raninduwathsal/Ratatouille/PCBS/Etching-Ready/Mainboaard/mainboard-Etching-ready-B_Cu.pdf

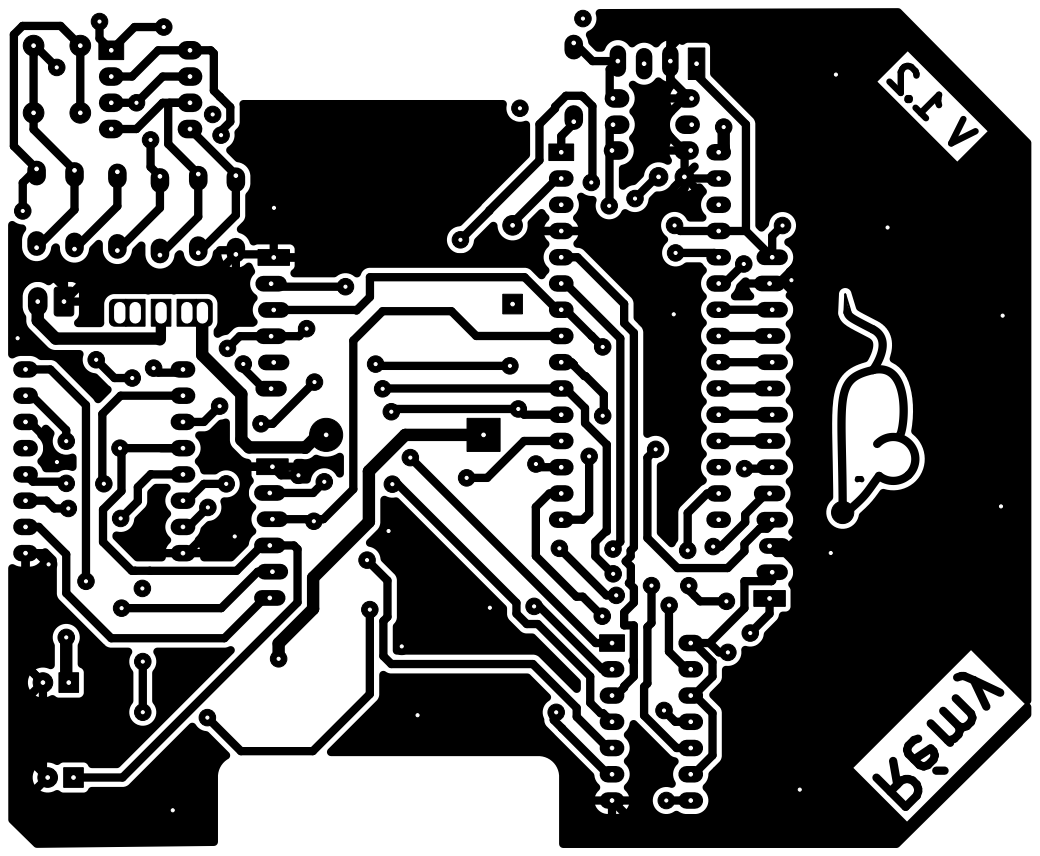
[picture p1: page 1]
