raninduwathsal/Ratatouille/PCBS/Etching-Ready/Mainboaard/mainboard-Etching-ready-F_Cu.pdf

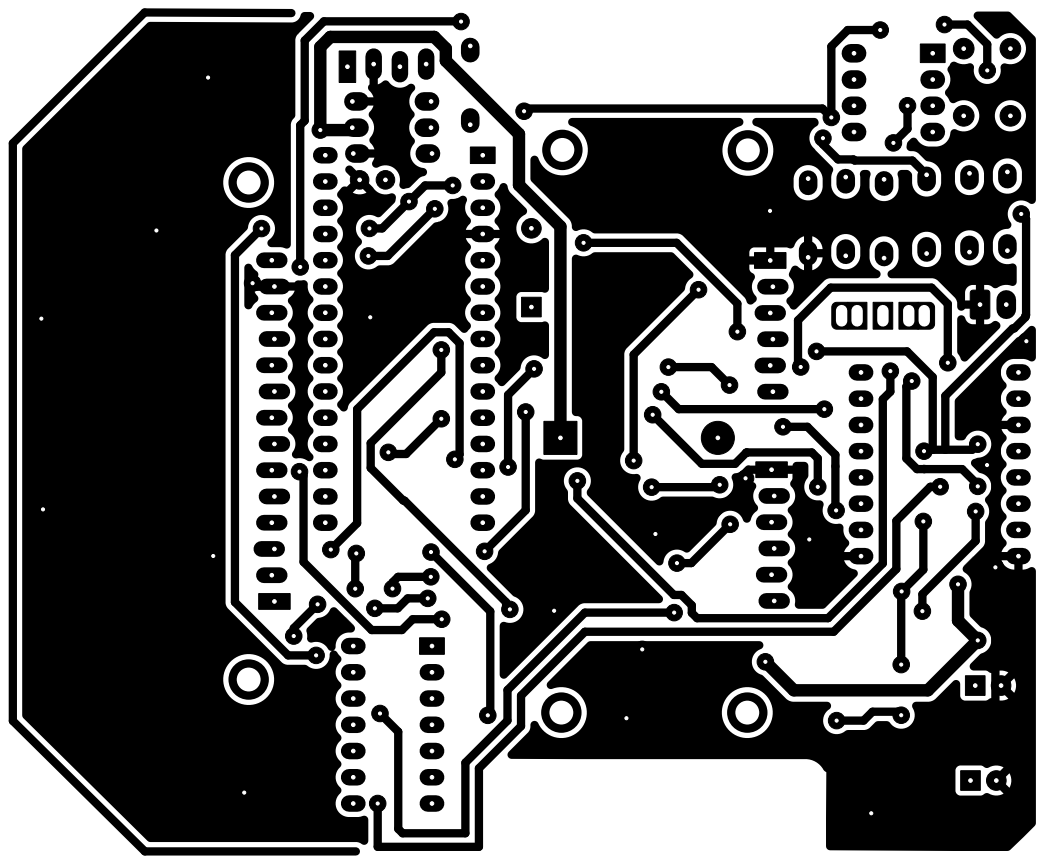
[picture p2: page 1]
