raninduwathsal/Ratatouille/PCBS/Etching-Ready/Wall-Sensor-Adavnced/wall-sensor-advanced-bottom_layer.pdf

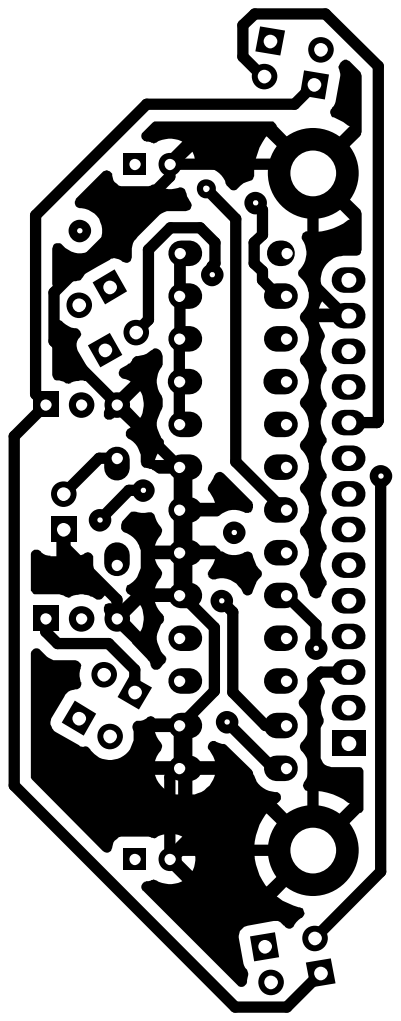
[picture p3: page 1]
