raninduwathsal/Ratatouille/PCBS/Etching-Ready/Wall-Sensor-Adavnced/wall-sensor-advanced-top_layer.pdf

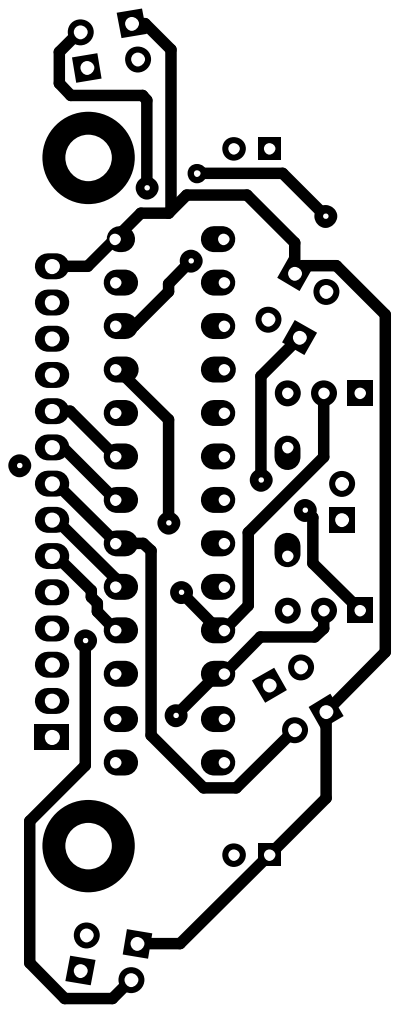
[picture p4: page 1]
