raninduwathsal/Ratatouille/PCBS/Ki-cad/mainboard-Etching-ready.kicad_pcb

## KiCad design PCBS/Ki-cad/mainboard-Etching-ready.kicad_pcb (2025-08-02)

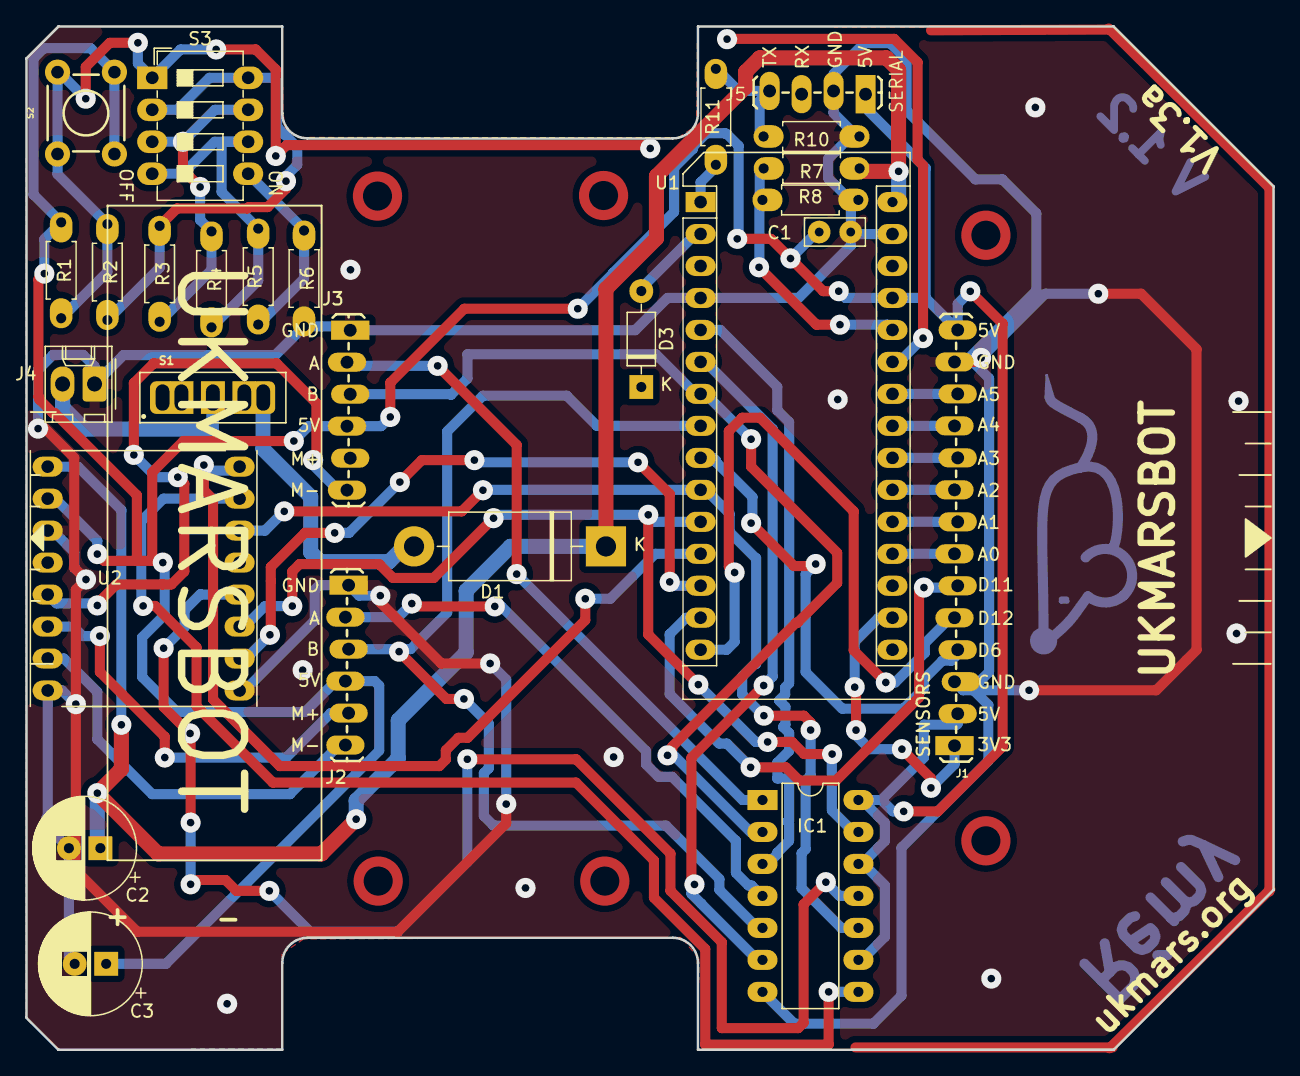
[picture p5: board mainboard-Etching-ready.kicad_pcb from above]

Board: 2 copper layers, 99.1 x 81.3 mm, 26 parts (0 on the bottom side), 41 nets.

Parts:
C1: 100n; C_Rect_L4.6mm_W2.0mm_P2.50mm_MKS02_FKP02
C2, C3: 330uF, 16V; CP_Radial_D8.0mm_P2.50mm
D1: 1N5401; D_DO-201AD_P15.24mm_Horizontal
D3: 1N4148; D_DO-35_SOD27_P7.62mm_Horizontal
IC1: 74HC86; DIP-14_W7.62mm_LongPads
J1: SENSORS; 1X14_LOCK_LONGPADS
J2, J3: CONN_06SILK_FEMALE_PTH; 1X06_LOCK_LONGPADS
J4: POWER; Molex_KK-254_AE-6410-02A_1x02_P2.54mm_Vertical
J5: SERIAL; 1X04_LOCK_LONGPADS
R1, R2, R10: 10k; R_Axial_DIN0207_L6.3mm_D2.5mm_P7.62mm_BIGPAD
R3, R11: 4k7; R_Axial_DIN0207_L6.3mm_D2.5mm_P7.62mm_BIGPAD
R4: 2k2; R_Axial_DIN0207_L6.3mm_D2.5mm_P7.62mm_BIGPAD
R5: 1k0; R_Axial_DIN0207_L6.3mm_D2.5mm_P7.62mm_BIGPAD
R6: 470; R_Axial_DIN0207_L6.3mm_D2.5mm_P7.62mm_BIGPAD
R7, R8: 15k; R_Axial_DIN0207_L6.3mm_D2.5mm_P7.62mm_BIGPAD
S1: sub-miniature, SPDT; SW_MINI-SPDT-RTECH-78-0564
S2: BUTTON; TACTILE_SWITCH_PTH_6.0MM
S3: DIP-SW; SW_DIP_SPSTx04_Slide_6.7x11.72mm_W7.62mm_P2.54mm_LowProfile
U1: Arduino_Nano
U2: TB6612FNG-Module; TB6612FNG-module

Connections:
5V: C1.1, C3.1, IC1.9, IC1.12, IC1.14 (VCC), J1.2, J1.14, J2.4, J3.4, J5.1, R1.2, S2.3, S2.4, U1.27 (+5V), U2.2 (VCC), U2.13 (STBY)
/3V3: J1.1, U1.17 (3V3)
/BATTERY_VOLTS: R7.1, R8.2, U1.26 (A7/D21)
/EMITTER_A: J1.6, U1.14 (~D11)
/EMITTER_B: J1.5, U1.15 (D12)
/FUNCTION_SELECT: R1.1, R2.2, S2.1, S2.2, S3.1, U1.25 (A6/D20)
/LEFT_A: IC1.1, J3.2
/LEFT_B: IC1.2, J3.3, U1.7 (D4)
/LEFT_CLK_A: IC1.3, U1.5 (D2)
/LEFT_DIR: IC1.10, U1.10 (D7), U2.14 (AI1)
/LEFT_MOTOR_1: J3.5, U2.4 (A01)
/LEFT_MOTOR_2: J3.6, U2.5 (A02)
/LEFT_PWM: U1.12 (~D9), U2.16 (PWMA)
/PWR_IN: J4.2, S1.2
/RIGHT_A: IC1.4, J2.2
/RIGHT_B: IC1.5, J2.3, U1.8 (~D5)
/RIGHT_CLK_A: IC1.6, U1.6 (~D3)
/RIGHT_DIR: IC1.13, U1.11 (D8), U2.11 (BI2)
/RIGHT_MOTOR_1: J2.6, U2.7 (B01)
/RIGHT_MOTOR_2: J2.5, U2.6 (B02)
/RIGHT_PWM: U1.13 (~D10), U2.10 (PWMB)
/RXD: D3.2 (A), U1.2 (D0/RX)
/RXD_BT: D3.1 (K), J5.3
/SENSOR_0: J1.7, U1.19 (A0/D14)
/SENSOR_1: J1.8, U1.20 (A1/D15)
/SENSOR_2: J1.9, U1.21 (A2/D16)
/SENSOR_3: J1.10, U1.22 (A3/D17)
/SENSOR_4: J1.11, U1.23 (A4/D18)
/SENSOR_5: J1.12, U1.24 (A5/D19)
/SW_PWR: D1.2 (A), S1.3 (S)
/TXD: R11.2, U1.1 (D1/TX)
/TXD_BT: J5.4, R10.1, R11.1
/USER_IO: J1.4, U1.9 (~D6)
/V_BATT: C2.1, D1.1 (K), R7.2, U1.30 (VIN), U2.1 (VM)
//LEFT_DIR: IC1.8, U2.15 (AI2)
//RIGHT_DIR: IC1.11, U2.12 (BI1)
GND: C1.2, C2.2, C3.2, IC1.7 (GND), J1.3, J1.13, J2.1, J3.1, J4.1, J5.2, R6.1, R8.1, R10.2, U1.4 (GND), U1.29 (GND), U2.3 (GND), U2.8 (GND), U2.9 (GND)
unnamed: R2.1, R3.2, S3.2 (1), S3.8 (2)
unnamed: R3.1, R4.2, S3.3 (1), S3.7 (2)
unnamed: R4.1, R5.1, S3.4 (1), S3.6 (2)
unnamed: R5.2, R6.2, S3.5 (2)
