raninduwathsal/Ratatouille/PCBS/Ki-cad/ukmarsbot-wall-sensor-advanced-etch diy.kicad_pcb

## KiCad design PCBS/Ki-cad/ukmarsbot-wall-sensor-advanced-etch diy.kicad_pcb (2025-07-12)

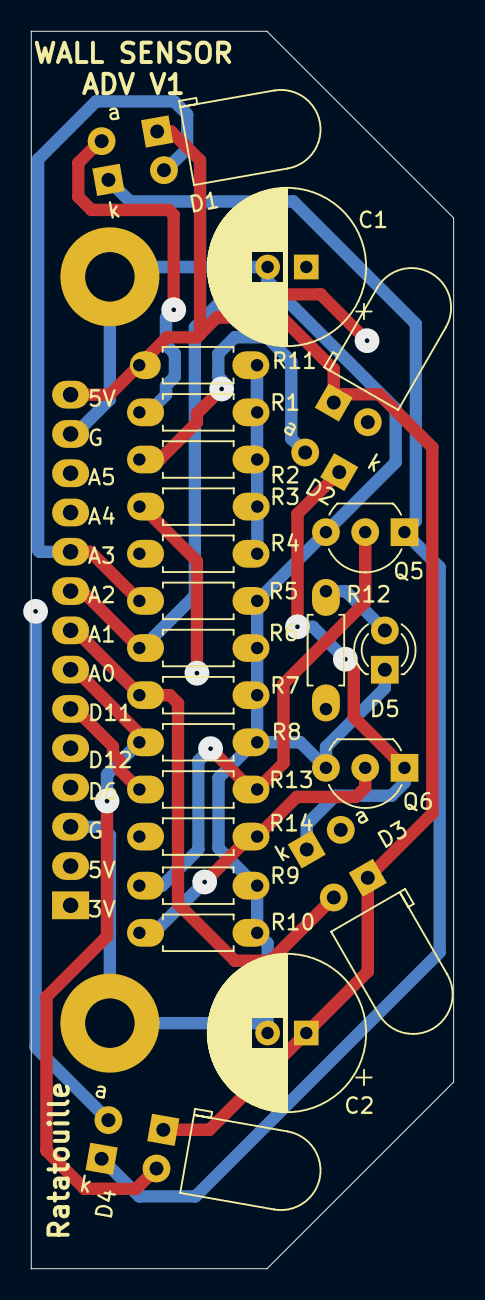
[picture p6: board ukmarsbot-wall-sensor-advanced-etch diy.kicad_pcb from above]

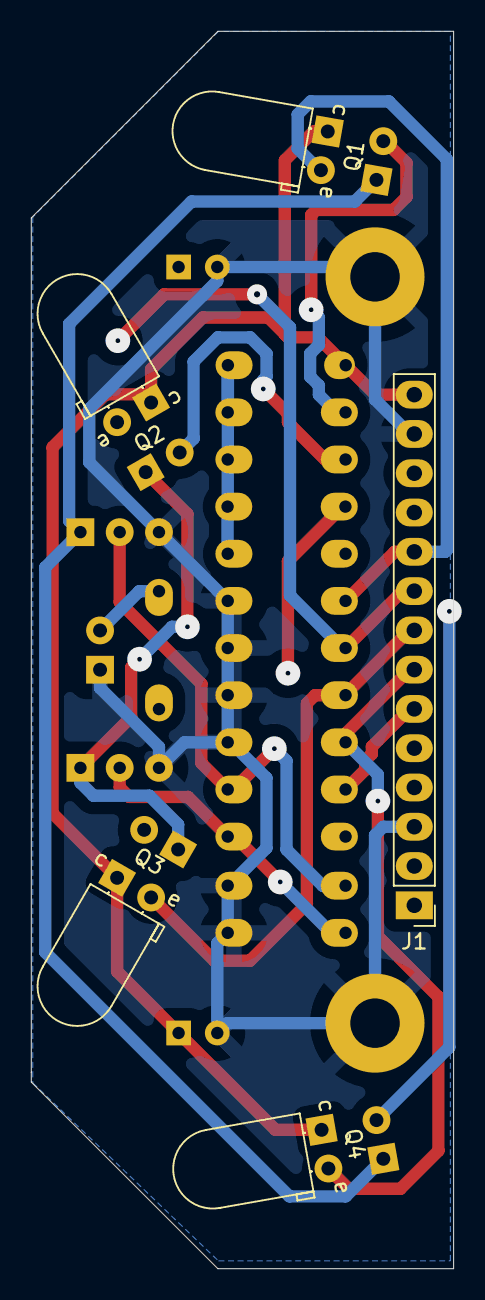
[picture p7: board ukmarsbot-wall-sensor-advanced-etch diy.kicad_pcb from below]

Board: 2 copper layers, 27.3 x 80.0 mm, 30 parts (5 on the bottom side), 19 nets.

Parts:
C1, C2: 330uF, 16V; CP_Radial_D10.0mm_P2.50mm
D1, D2, D3, D4: SFH4545; LED_D5.0mm_Horizontal_O6.35mm_Z3.0mm
D5: LED; LED_D3.0mm
H1, H2: 3.2mm; MountingHole_3.2mm_M3_Pad
J1: Conn_01x14; PinHeader_1x14_P2.54mm_Vertical_Longpads
Q1, Q2, Q3, Q4: TEFT4300; LED_D5.0mm_Horizontal_O1.27mm_Z3.0mm_IRGrey
Q5, Q6: BC337; TO-92_Inline_Wide_HandSolder
R1, R2, R3, R4: 10R; R_Axial_DIN0207_L6.3mm_D2.5mm_P7.62mm_BIGPAD
R5, R6, R7, R8: 1k8; R_Axial_DIN0207_L6.3mm_D2.5mm_P7.62mm_BIGPAD
R9, R10: 100k; R_Axial_DIN0207_L6.3mm_D2.5mm_P7.62mm_BIGPAD
R11: 33; R_Axial_DIN0207_L6.3mm_D2.5mm_P7.62mm_BIGPAD
R12: 1k0; R_Axial_DIN0207_L6.3mm_D2.5mm_P7.62mm_BIGPAD
R13, R14: 390R; R_Axial_DIN0207_L6.3mm_D2.5mm_P7.62mm_BIGPAD

Connections:
5V: C2.1, J1.14, Q1.1 (C), Q2.1 (C), Q3.1 (C), Q4.1 (C), R11.2
/DIA_COMMON: D2.1 (K), D3.1 (K), Q6.1 (C)
/FWD_COMMON: D1.1 (K), D4.1 (K), Q5.1 (C)
A0_RF: J1.7, Q4.2 (E), R8.1
A1_RD: J1.8, Q3.2 (E), R7.1
A2_LD: J1.9, Q2.2 (E), R6.1
A3_LF: J1.10, Q1.2 (E), R5.1
D6_LED: J1.4, R12.2
D11_FRONT: J1.6, R13.1
D12_DIAGONAL: J1.5, R14.1
GND: C1.2, C2.2, D5.1 (K), H1.1, H2.1, J1.3, J1.13, Q5.3 (E), Q6.3 (E), R5.2, R6.2, R7.2, R8.2, R9.2, R10.2
unnamed: D1.2 (A), R1.1
unnamed: D2.2 (A), R2.1
unnamed: D3.2 (A), R3.1
unnamed: D4.2 (A), R4.1
unnamed: D5.2 (A), R12.1
unnamed: Q5.2 (B), R9.1, R13.2
unnamed: Q6.2 (B), R10.1, R14.2
V_LED: C1.1, R1.2, R2.2, R3.2, R4.2, R11.1
