raninduwathsal/Ratatouille/(commit log)

2025-07-12 PCB etch files
2025-07-12 Ki cad files for Etch ready PCB
    [mainboard-Etching-ready.kicad_pcb, ukmarsbot-wall-sensor-advanced-etch diy.kicad_pcb]
2025-07-27 Fix the Pcb Mirrored issue and Make soldering easier
2025-08-02 ki cad files update according to easier to solder versions
    [mainboard-Etching-ready.kicad_pcb]
